waterloo-rocketry/controls-2025-electrical/README.md

2025 Controls Electrical Design
===============================
