waterloo-rocketry/controls-2025-electrical/motor_control_board/motor_control_board.kicad_pcb

## KiCad design motor_control_board/motor_control_board.kicad_pcb (2024-12-03)

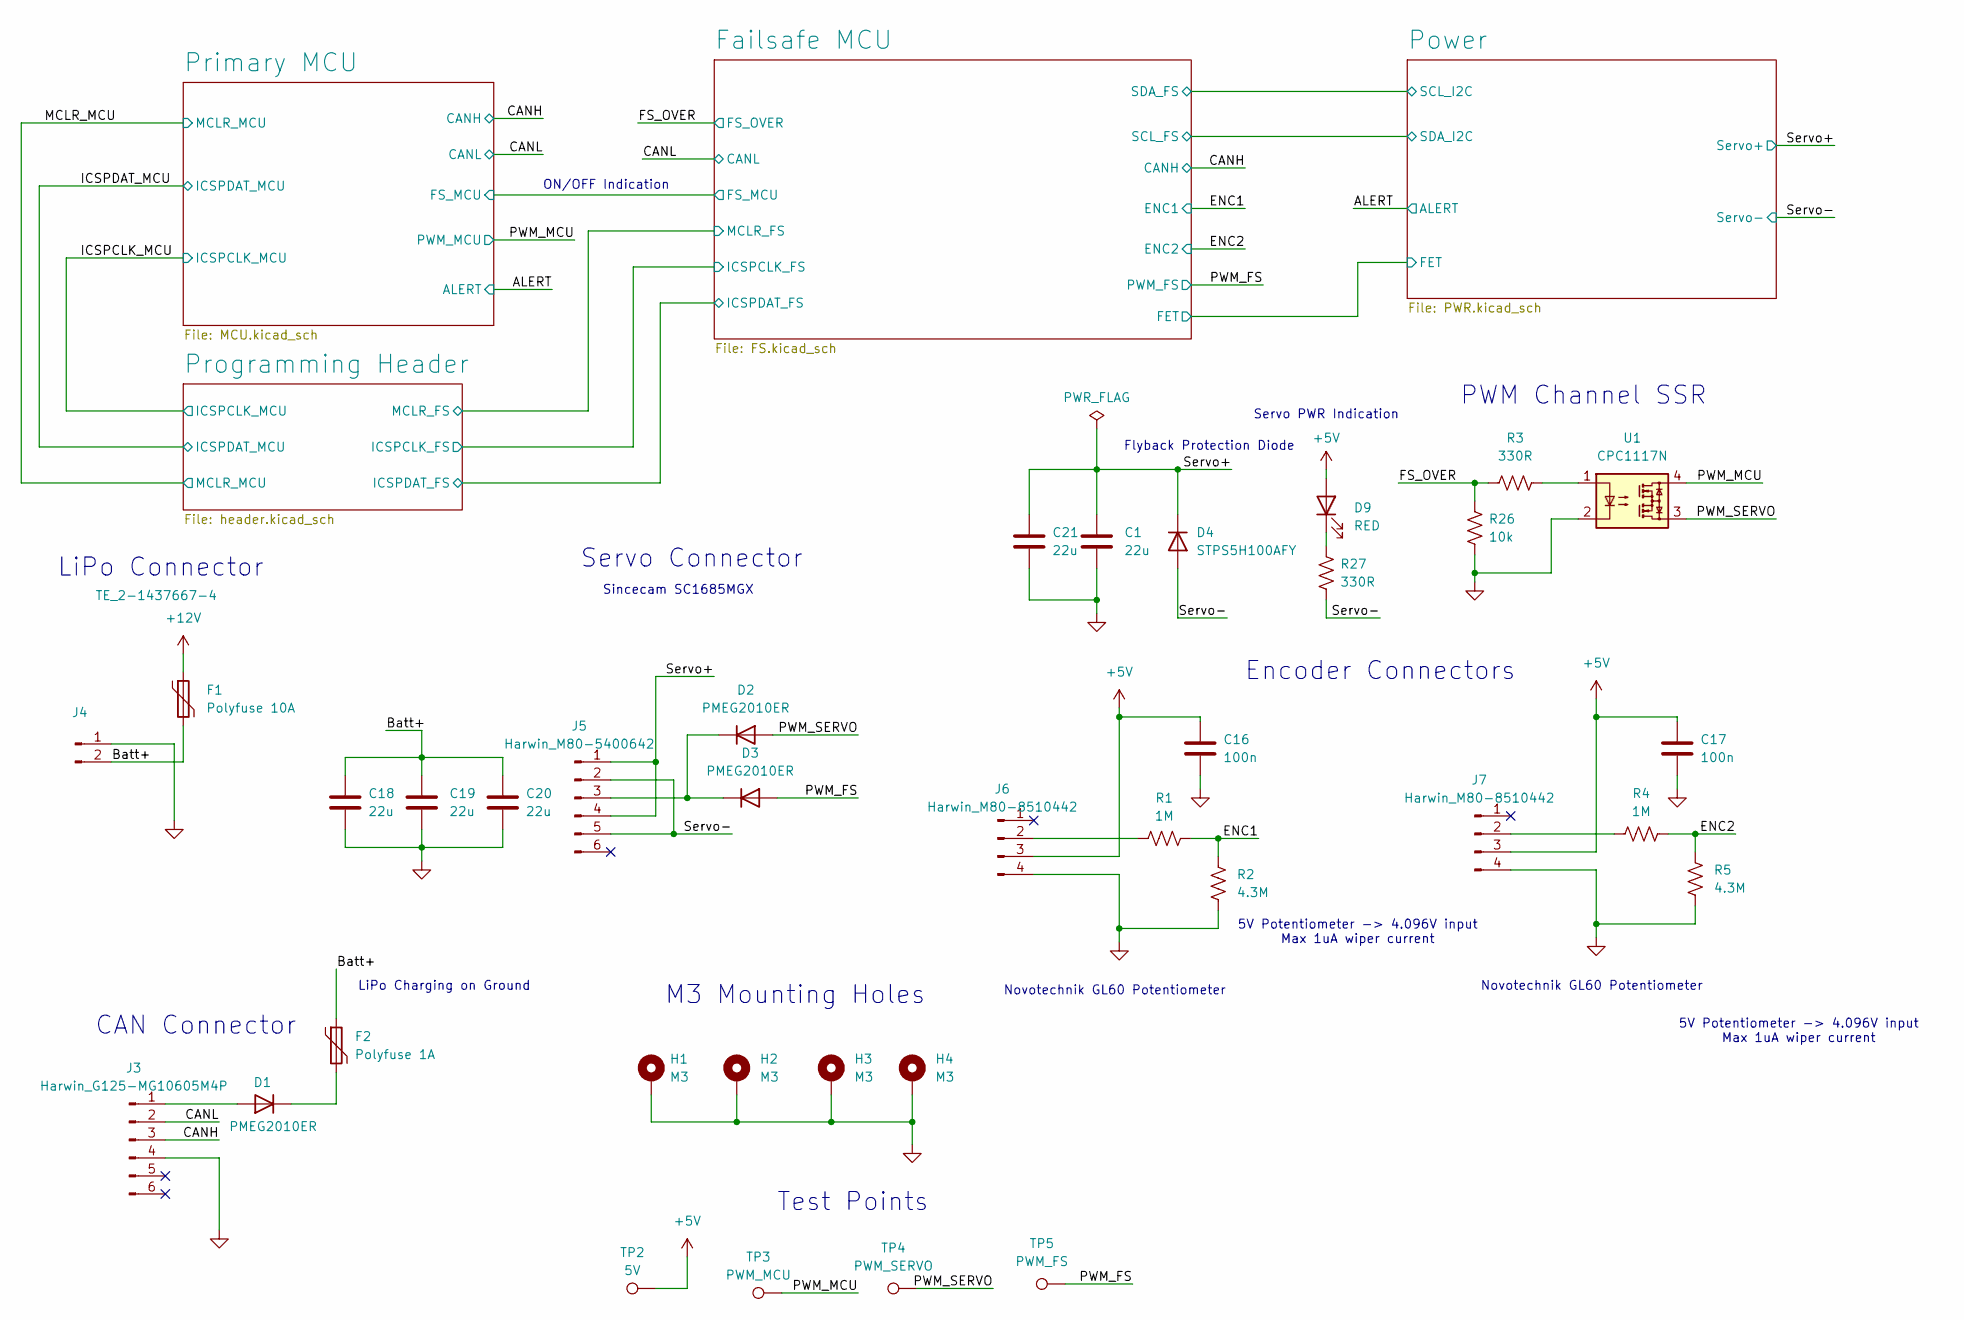
[picture p6: schematic motor_control_board.kicad_sch, Motor Control Board]

Parts:
C1, C18, C19, C20, C21: 22u; C_0805_2012Metric_Pad1.18x1.45mm_HandSolder
C16, C17: 100n; C_0805_2012Metric_Pad1.18x1.45mm_HandSolder
D1, D2, D3: PMEG2010ER; Nexperia_CFP3_SOD-123W
D4: STPS5H100AFY; D_SOD-128
D9: RED; LED_1206_3216Metric_Pad1.42x1.75mm_HandSolder
F1: Polyfuse 10A; Fuse_1206_3216Metric_Pad1.42x1.75mm_HandSolder
F2: Polyfuse 1A; Fuse_1206_3216Metric_Pad1.42x1.75mm_HandSolder
H1, H2, H3, H4: M3; MountingHole_3.2mm_M3_DIN965_Pad
J3: Harwin_G125-MG10605M4P; connector_Harwin_G125–MG10605M4P
J4: TE_2-1437667-4
J5: Harwin_M80-5400642; HARWIN_M80-5400642
J6, J7: Harwin_M80-8510442; HARWIN_M80-8510442
R1, R4: 1M; R_0805_2012Metric_Pad1.20x1.40mm_HandSolder
R2, R5: 4.3M; R_0805_2012Metric_Pad1.20x1.40mm_HandSolder
R3, R27: 330R; R_0805_2012Metric_Pad1.20x1.40mm_HandSolder
R26: 10k; R_0805_2012Metric_Pad1.20x1.40mm_HandSolder
TP2: 5V; TestPoint_Keystone_5000-5004_Miniature
TP3: PWM_MCU; TestPoint_Keystone_5000-5004_Miniature
TP4: PWM_SERVO; TestPoint_Keystone_5000-5004_Miniature
TP5: PWM_FS; TestPoint_Keystone_5000-5004_Miniature
U1: CPC1117N; SOIC254P610X218-4N

Connections:
+5V: C16.1, C17.1, D9.2 (A), J6.3, J7.3, TP2.1; also elsewhere on the board
+12V: F1.1; also elsewhere on the board
/Batt+: C18.1, C19.1, C20.1, F1.2, F2.1, J4.2
/CANH: J3.3; also elsewhere on the board
/CANL: J3.2; also elsewhere on the board
/ENC1: R1.2, R2.1; also elsewhere on the board
/ENC2: R4.2, R5.1; also elsewhere on the board
/FS_OVER: R3.1, R26.1; also elsewhere on the board
/PWM_FS: D3.2 (A), TP5.1; also elsewhere on the board
/PWM_MCU: TP3.1, U1.4; also elsewhere on the board
/PWM_SERVO: D2.2 (A), TP4.1, U1.3
/Servo+: C1.1, C21.1, D4.1 (K), J5.1, J5.4; also elsewhere on the board
/Servo-: D4.2 (A), J5.2, J5.5, R27.2; also elsewhere on the board
GND: C1.2, C16.2, C17.2, C18.2, C19.2, C20.2, C21.2, H1.1, H2.1, H3.1, H4.1, J3.4, J4.1, J6.4, J7.4, R2.2, R5.2, R26.2, U1.2; also elsewhere on the board
unnamed: D1.2 (A), J3.1
unnamed: D1.1 (K), F2.2
unnamed: D2.1 (K), D3.1 (K), J5.3
unnamed: D9.1 (K), R27.1
unnamed: J6.2, R1.1
unnamed: J7.2, R4.1
unnamed: R3.2, U1.1

Notes on the sheet:
Novotechnik GL60 Potentiometer
5V Potentiometer -> 4.096V input Max 1uA wiper current
Flyback Protection Diode
Servo PWR Indication
Servo Connector
M3 Mounting Holes
LiPo Charging on Ground
Sincecam SC1685MGX
ON/OFF Indication
Test Points
PWM Channel SSR
LiPo Connector
Encoder Connectors
CAN Connector

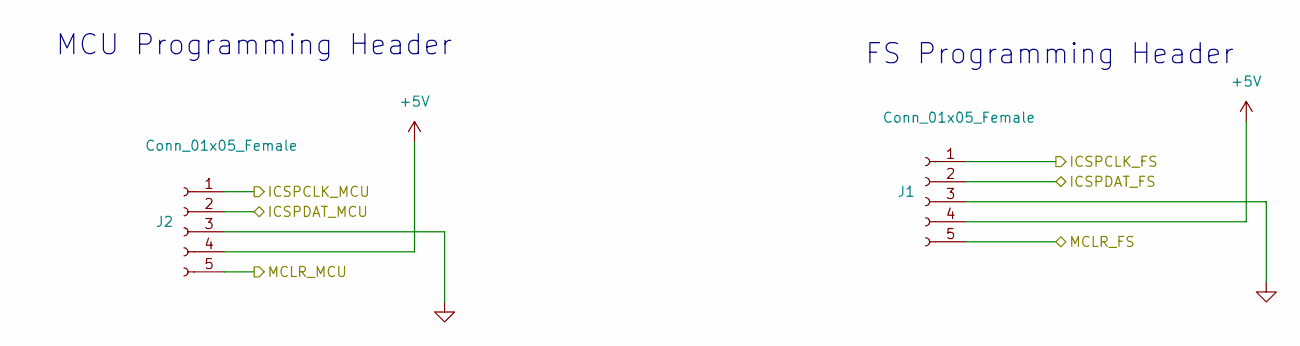
[picture p7: schematic header.kicad_sch]

Parts:
J1, J2: Conn_01x05_Female; PinSocket_5x2.54_SMD_90deg_952-3198-1-ND

Connections:
+5V: J1.4, J2.4; also elsewhere on the board
/Failsafe MCU/ICSPCLK_FS: J1.1; also elsewhere on the board
/Failsafe MCU/ICSPDAT_FS: J1.2; also elsewhere on the board
/Failsafe MCU/MCLR_FS: J1.5; also elsewhere on the board
/ICSPCLK_MCU: J2.1; also elsewhere on the board
/ICSPDAT_MCU: J2.2; also elsewhere on the board
/MCLR_MCU: J2.5; also elsewhere on the board
GND: J1.3, J2.3; also elsewhere on the board

Notes on the sheet:
FS Programming Header
MCU Programming Header

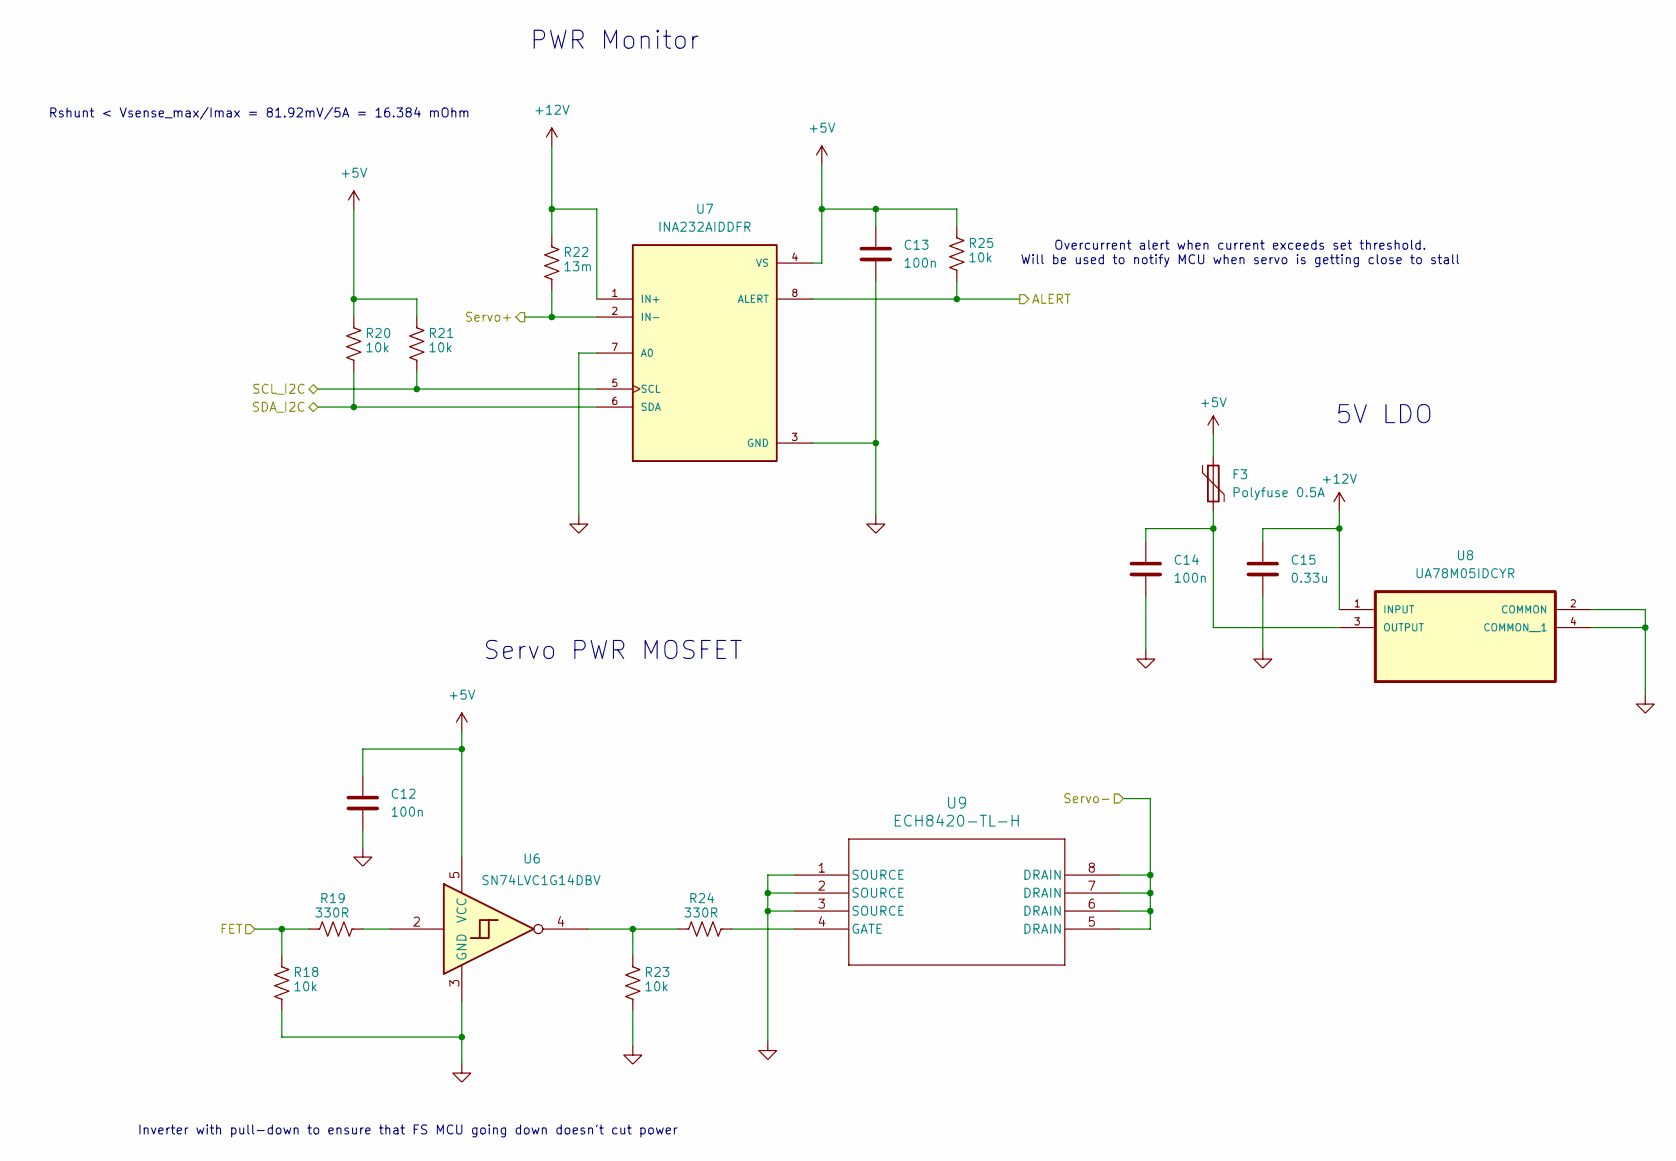
[picture p8: schematic PWR.kicad_sch]

Parts:
C12, C13, C14: 100n; C_0805_2012Metric_Pad1.18x1.45mm_HandSolder
C15: 0.33u; C_0805_2012Metric_Pad1.18x1.45mm_HandSolder
F3: Polyfuse 0.5A; Fuse_1206_3216Metric_Pad1.42x1.75mm_HandSolder
R18, R20, R21, R23, R25: 10k; R_0805_2012Metric_Pad1.20x1.40mm_HandSolder
R19, R24: 330R; R_0805_2012Metric_Pad1.20x1.40mm_HandSolder
R22: 13m; R_1206_3216Metric_Pad1.30x1.75mm_HandSolder
U6: SN74LVC1G14DBV; SOT-23-5
U7: INA232AIDDFR; SOT65P280X110-8N; PARTREV December 2022
U8: UA78M05IDCYR; SOT230P700X180-4N
U9: ECH8420-TL-H; OnSemi_ECH8

Connections:
+5V: C12.1, C13.1, F3.1, R20.1, R21.1, R25.1, U6.5 (VCC), U7.4 (VS); also elsewhere on the board
+12V: C15.1, R22.1, U7.1 (IN+), U8.1 (INPUT); also elsewhere on the board
/ALERT: R25.2, U7.8 (ALERT); also elsewhere on the board
/Failsafe MCU/FET: R18.1, R19.1; also elsewhere on the board
/Failsafe MCU/SCL_FS: R20.2, U7.6 (SDA); also elsewhere on the board
/Failsafe MCU/SDA_FS: R21.2, U7.5 (SCL); also elsewhere on the board
/Servo+: R22.2, U7.2 (IN-); also elsewhere on the board
/Servo-: U9.5 (DRAIN), U9.6 (DRAIN), U9.7 (DRAIN), U9.8 (DRAIN); also elsewhere on the board
GND: C12.2, C13.2, C14.2, C15.2, R18.2, R23.2, U6.3 (GND), U7.3 (GND), U7.7 (A0), U8.2 (COMMON), U8.4 (COMMON__1), U9.1 (SOURCE), U9.2 (SOURCE), U9.3 (SOURCE); also elsewhere on the board
unnamed: R19.2, U6.2
unnamed: R23.1, R24.1, U6.4
unnamed: C14.1, F3.2, U8.3 (OUTPUT)
unnamed: R24.2, U9.4 (GATE)

Notes on the sheet:
Servo PWR MOSFET
PWR Monitor
Inverter with pull-down to ensure that FS MCU going down doesn't cut power
5V LDO
Overcurrent alert when current exceeds set threshold. Will be used to notify MCU when servo is getting close to stall
Rshunt < Vsense_max/Imax = 81.92mV/5A = 16.384 mOhm

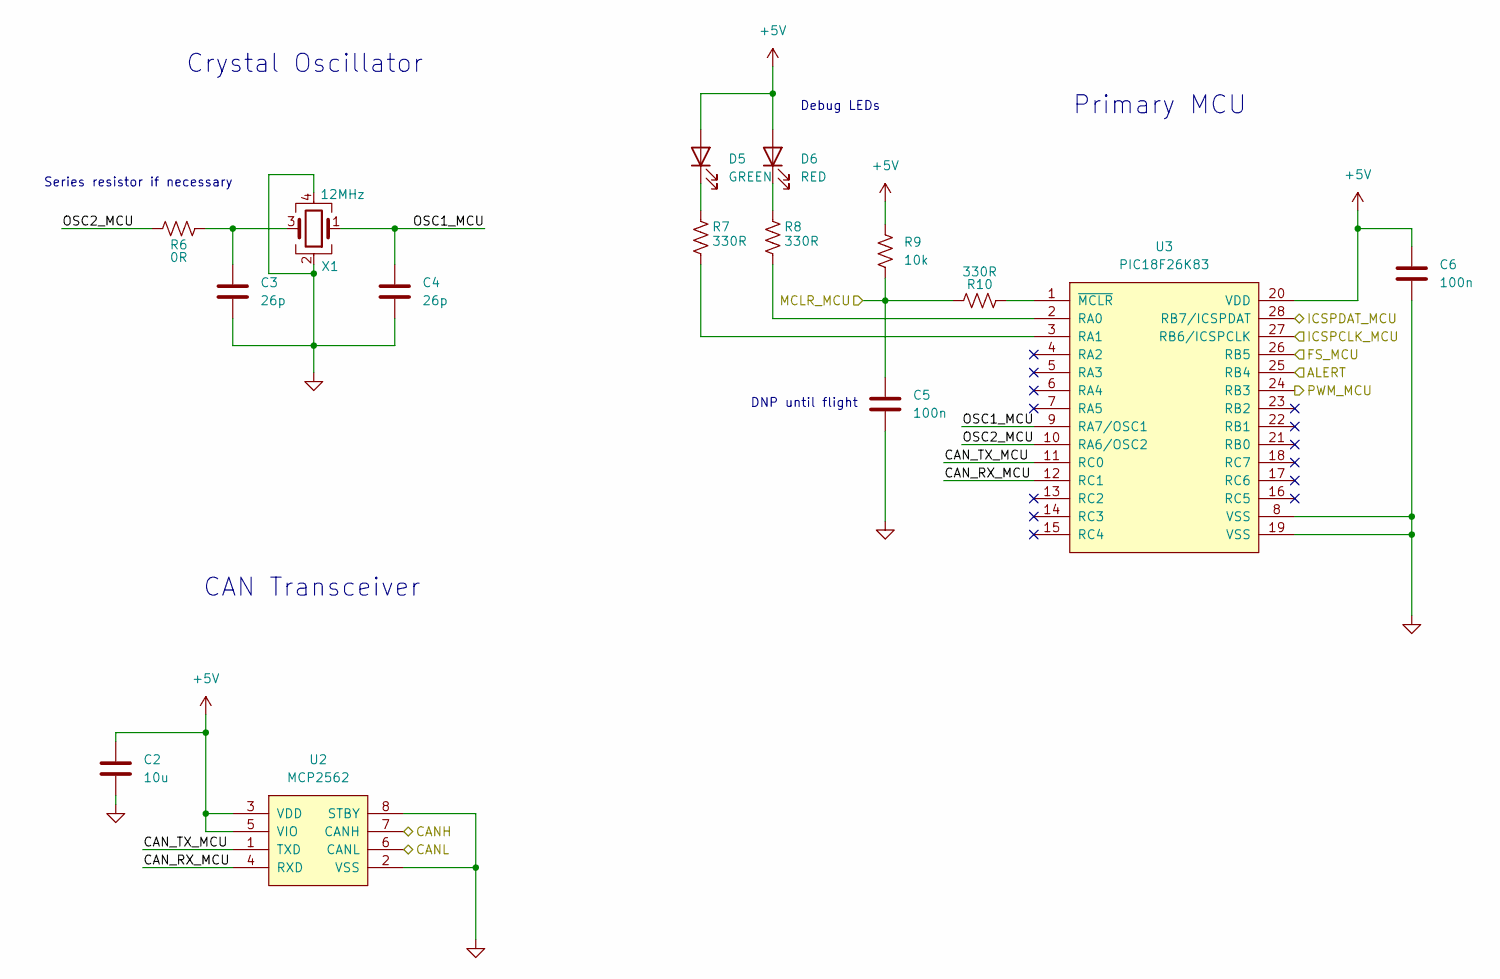
[picture p9: schematic MCU.kicad_sch]

Parts:
C2: 10u; C_0805_2012Metric_Pad1.18x1.45mm_HandSolder
C3, C4: 26p; C_0805_2012Metric_Pad1.18x1.45mm_HandSolder
C5, C6: 100n; C_0805_2012Metric_Pad1.18x1.45mm_HandSolder
D5: GREEN; LED_1206_3216Metric_Pad1.42x1.75mm_HandSolder
D6: RED; LED_1206_3216Metric_Pad1.42x1.75mm_HandSolder
R6: 0R; R_0805_2012Metric_Pad1.20x1.40mm_HandSolder
R7, R8, R10: 330R; R_0805_2012Metric_Pad1.20x1.40mm_HandSolder
R9: 10k; R_0805_2012Metric_Pad1.20x1.40mm_HandSolder
U2: MCP2562; SOIC-8_3.9x4.9mm_P1.27mm
U3: PIC18F26K83; SSOP-28_5.3x10.2mm_P0.65mm
X1: 12MHz; Crystal_SMD_Abracon_ABM8G-4Pin_3.2x2.5mm

Connections:
+5V: C2.1, C6.1, D5.2 (A), D6.2 (A), R9.1, U2.3 (VDD), U2.5 (VIO), U3.20 (VDD); also elsewhere on the board
/ALERT: U3.25 (RB4); also elsewhere on the board
/CANH: U2.7 (CANH); also elsewhere on the board
/CANL: U2.6 (CANL); also elsewhere on the board
/Failsafe MCU/FS_MCU: U3.26 (RB5); also elsewhere on the board
/ICSPCLK_MCU: U3.27 (RB6/ICSPCLK); also elsewhere on the board
/ICSPDAT_MCU: U3.28 (RB7/ICSPDAT); also elsewhere on the board
/MCLR_MCU: C5.1, R9.2, R10.2; also elsewhere on the board
/PWM_MCU: U3.24 (RB3); also elsewhere on the board
/Primary MCU/CAN_RX_MCU: U2.4 (RXD), U3.12 (RC1)
/Primary MCU/CAN_TX_MCU: U2.1 (TXD), U3.11 (RC0)
/Primary MCU/OSC1_MCU: C4.1, U3.9 (RA7/OSC1), X1.1
/Primary MCU/OSC2_MCU: R6.1, U3.10 (RA6/OSC2)
GND: C2.2, C3.2, C4.2, C5.2, C6.2, U2.2 (VSS), U2.8 (STBY), U3.8 (VSS), U3.19 (VSS), X1.2, X1.4; also elsewhere on the board
unnamed: C3.1, R6.2, X1.3
unnamed: D5.1 (K), R7.1
unnamed: D6.1 (K), R8.1
unnamed: R8.2, U3.2 (RA0)
unnamed: R7.2, U3.3 (RA1)
unnamed: R10.1, U3.1 (~MCLR)

Notes on the sheet:
DNP until flight
Series resistor if necessary
Crystal Oscillator
Primary MCU
CAN Transceiver
Debug LEDs

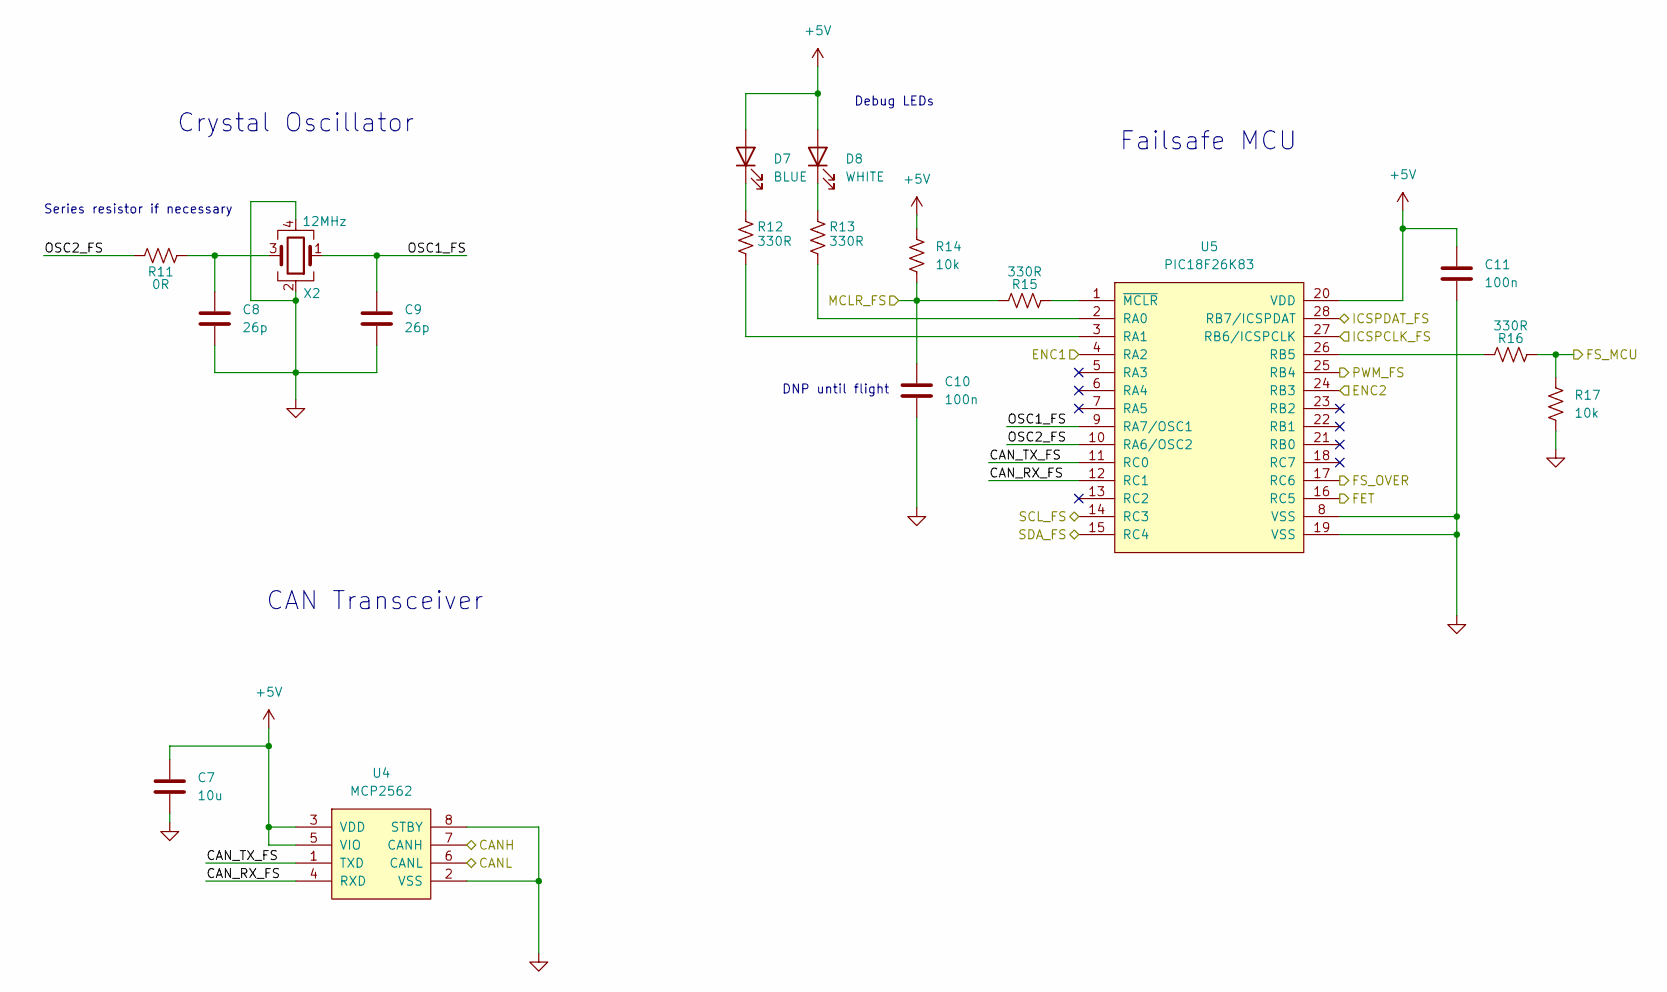
[picture p10: schematic FS.kicad_sch]

Parts:
C7: 10u; C_0805_2012Metric_Pad1.18x1.45mm_HandSolder
C8, C9: 26p; C_0805_2012Metric_Pad1.18x1.45mm_HandSolder
C10, C11: 100n; C_0805_2012Metric_Pad1.18x1.45mm_HandSolder
D7: BLUE; LED_1206_3216Metric_Pad1.42x1.75mm_HandSolder
D8: WHITE; LED_1206_3216Metric_Pad1.42x1.75mm_HandSolder
R11: 0R; R_0805_2012Metric_Pad1.20x1.40mm_HandSolder
R12, R13, R15, R16: 330R; R_0805_2012Metric_Pad1.20x1.40mm_HandSolder
R14, R17: 10k; R_0805_2012Metric_Pad1.20x1.40mm_HandSolder
U4: MCP2562; SOIC-8_3.9x4.9mm_P1.27mm
U5: PIC18F26K83; SSOP-28_5.3x10.2mm_P0.65mm
X2: 12MHz; Crystal_SMD_Abracon_ABM8G-4Pin_3.2x2.5mm

Connections:
+5V: C7.1, C11.1, D7.2 (A), D8.2 (A), R14.1, U4.3 (VDD), U4.5 (VIO), U5.20 (VDD); also elsewhere on the board
/CANH: U4.7 (CANH); also elsewhere on the board
/CANL: U4.6 (CANL); also elsewhere on the board
/ENC1: U5.4 (RA2); also elsewhere on the board
/ENC2: U5.24 (RB3); also elsewhere on the board
/FS_OVER: U5.17 (RC6); also elsewhere on the board
/Failsafe MCU/CAN_RX_FS: U4.4 (RXD), U5.12 (RC1)
/Failsafe MCU/CAN_TX_FS: U4.1 (TXD), U5.11 (RC0)
/Failsafe MCU/FET: U5.16 (RC5); also elsewhere on the board
/Failsafe MCU/FS_MCU: R16.1, R17.1; also elsewhere on the board
/Failsafe MCU/ICSPCLK_FS: U5.27 (RB6/ICSPCLK); also elsewhere on the board
/Failsafe MCU/ICSPDAT_FS: U5.28 (RB7/ICSPDAT); also elsewhere on the board
/Failsafe MCU/MCLR_FS: C10.1, R14.2, R15.2; also elsewhere on the board
/Failsafe MCU/OSC1_FS: C9.1, U5.9 (RA7/OSC1), X2.1
/Failsafe MCU/OSC2_FS: R11.1, U5.10 (RA6/OSC2)
/Failsafe MCU/SCL_FS: U5.14 (RC3); also elsewhere on the board
/Failsafe MCU/SDA_FS: U5.15 (RC4); also elsewhere on the board
/PWM_FS: U5.25 (RB4); also elsewhere on the board
GND: C7.2, C8.2, C9.2, C10.2, C11.2, R17.2, U4.2 (VSS), U4.8 (STBY), U5.8 (VSS), U5.19 (VSS), X2.2, X2.4; also elsewhere on the board
unnamed: C8.1, R11.2, X2.3
unnamed: D7.1 (K), R12.1
unnamed: D8.1 (K), R13.1
unnamed: R13.2, U5.2 (RA0)
unnamed: R12.2, U5.3 (RA1)
unnamed: R16.2, U5.26 (RB5)
unnamed: R15.1, U5.1 (~MCLR)

Notes on the sheet:
Failsafe MCU
Crystal Oscillator
CAN Transceiver
Debug LEDs
DNP until flight
Series resistor if necessary

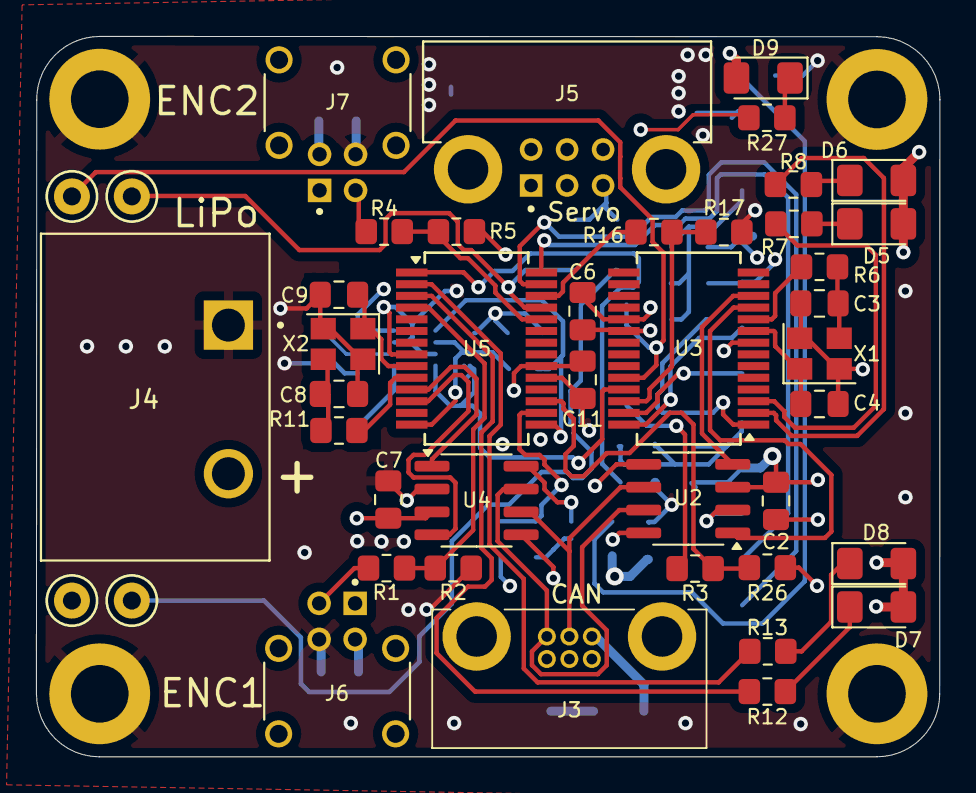
[picture p11: board motor_control_board.kicad_pcb from above]

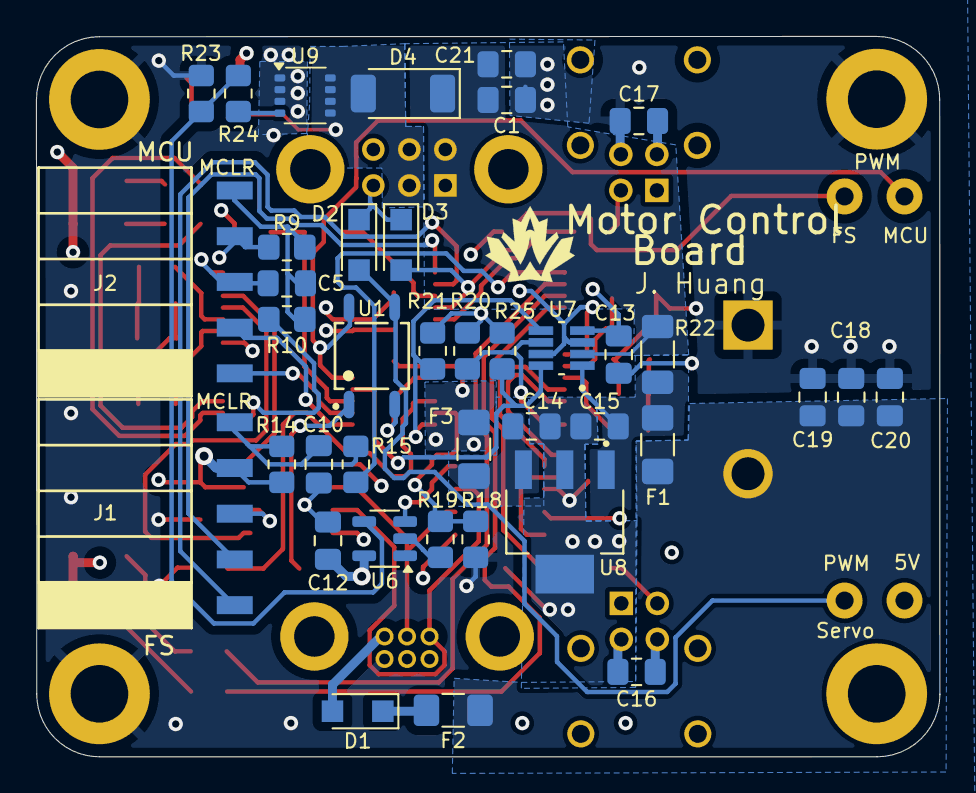
[picture p12: board motor_control_board.kicad_pcb from below]

Board: 4 copper layers, 50.2 x 40.0 mm, 86 parts (39 on the bottom side), 57 nets.
